vqlion/P2I-Boccia-ramp/README.md

# Boccia ramp project
An android & arduino project. The android app is used to control motors via Arduino.

## Description

This project is made in the context of INSA Lyon 2nd year project, the P2I.
The goal of the project is to create an automated [boccia](https://en.wikipedia.org/wiki/Boccia) ramp. This archive contains android code as well as arduino code. 
The android app is made to send information via internet to an arduino ESP8266 on a NodeMCU, which is then connected via I2C to an arduino MEGA2560 with a motor shield rev3 on top of it to control motors.

The project is now ended and the ramp looks like this :

3D rendering of the final project

With two motors, one at the bottom to rotate the ramp and one on the foot to change the height of the ball, four limit switches (two on the base to limit the rotation and two on the ramp to limit the height), a LED (not visible on this view) and an emergency button on the base.

## Wiring

More details on wiring [here](Figures).
The boards are setup like so :

Diagram of the arduino circuits

The motor shield is on the mega, I separated them in the diagram for clarity. 

I used EMG30 motors from Robot Electronics. The arduino code is able to support the 2 motors in direction and PWN, and get the encoder position from each motor.
You can use any DC motor if you don't need the encoder position, just ignore the Hall sensor pins.
