vqlion/P2I-Boccia-ramp/Figures/diagram.jpg

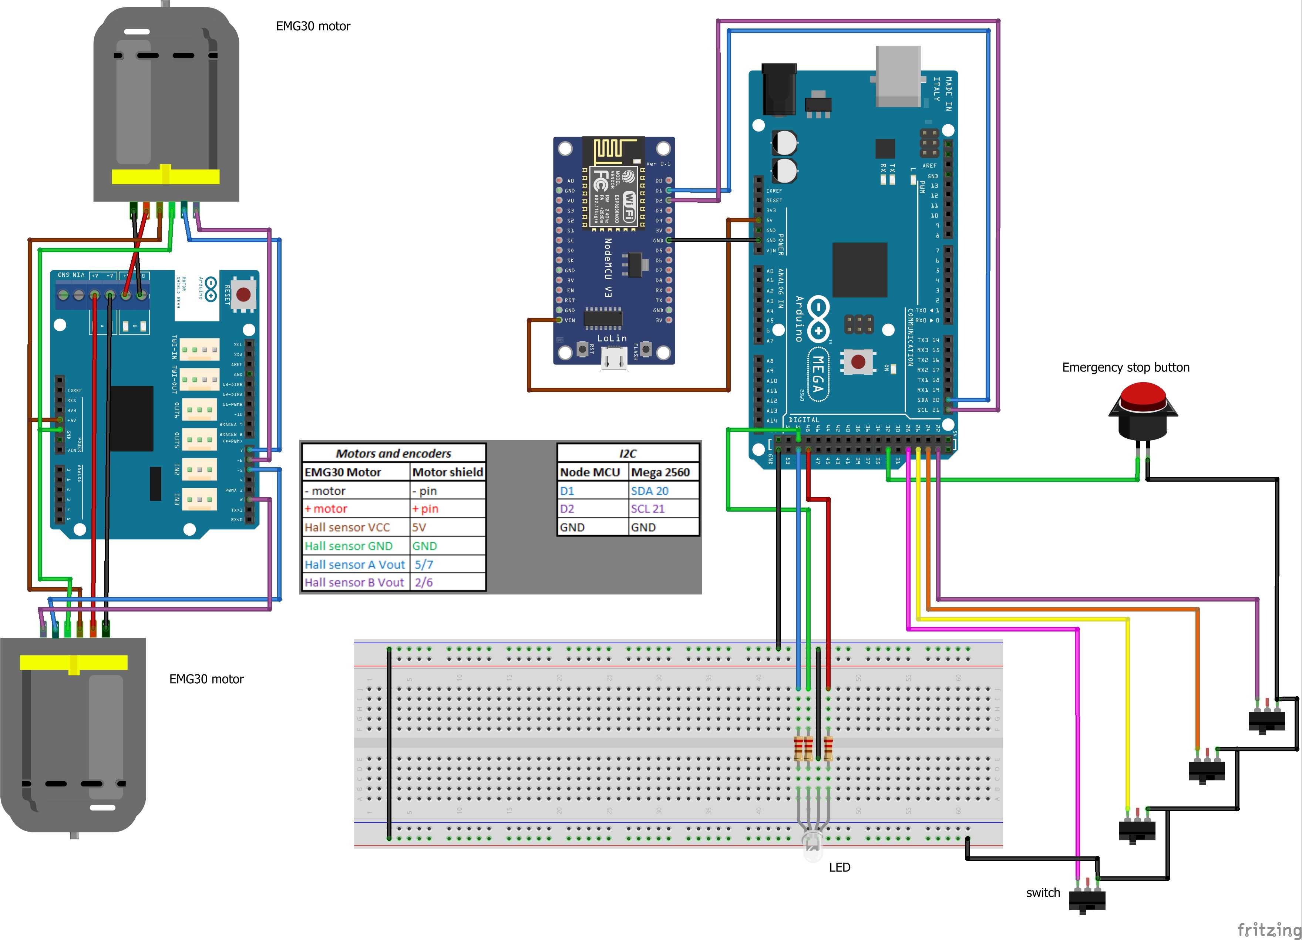
Figures/diagram.jpg
