vqlion/P2I-Boccia-ramp/Figures/schematics.jpg

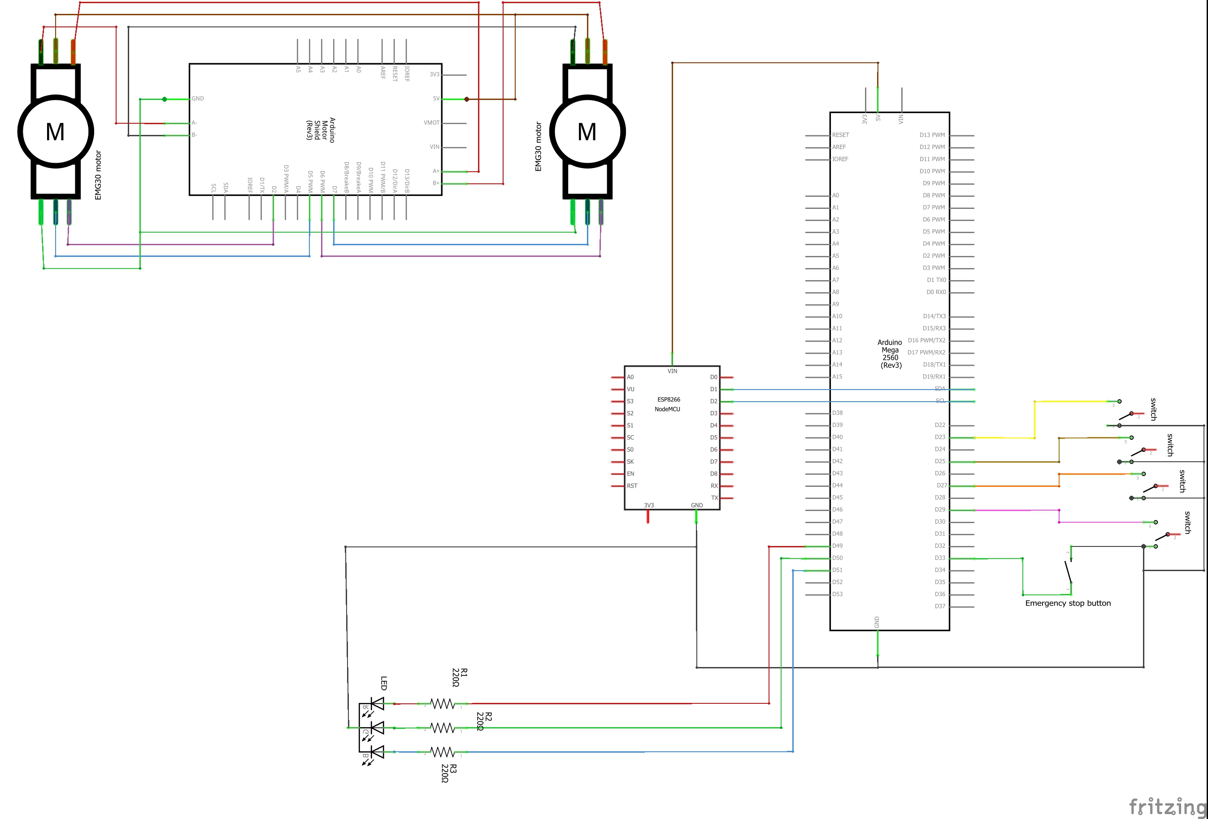
Figures/schematics.jpg
