vqlion/P2I-Boccia-ramp/Figures/Wiring.xlsx

Motors and encoders |  | I2C |  | Limit switches |  | RGB LED
EMG30 Motor | Motor shield | Node MCU | Mega 2560 | Switch | Mega 2560 | LED | Mega 2560
- motor | - pin | D1 | SDA 20 | C pin | 22/24/26/28 | Red | 49
+ motor | + pin | D2 | SCL 21 | NO pin | GND | Green | 50
Hall sensor VCC | 5V | GND | GND |  |  | Blue | 51
Hall sensor GND | GND |  |  |  |  | GND | GND
Hall sensor A Vout | 5/7
Hall sensor B Vout | 2/6
