vqlion/P2I-Boccia-ramp/(commit log)

2022-05-09 Create diagram 2 motors.jpg
2022-05-11 Updated and cleaned arduino code
2022-05-12 Added support for a RGB led and updated the figures
2022-05-18 Fully working app and arduino code updated to regulate motors with encoders
2022-05-20 Added support for 4 micro switches to calibrate the ramp, and updated the figures accordingly
2022-05-23 Added support for an emergency stop button and fixed bugs in calibrate
    [I2C_Slave_modif.ino]
2022-05-23 Updated wiring figures
2022-05-25 Updated wiring and added xlsx for wiring and comm protocol
    [Communication protocol.xlsx, Wiring.xlsx]
2022-05-30 Fixed bugs and added comment in Arduino
    [Communication protocol.xlsx]
2022-06-03 Improve security in arduino code
